joe1505/mhz100q/README.md

# mhz100q

Cloned from SourceForge. For now, see http://mhz100q.sourceforge.net/
