joe1505/mhz100q/pcb/kicad/mhz100q.sch

## KiCad design pcb/kicad/mhz100q.sch (2009-04-13)

Schematic: mhz100q.sch

Parts:
C1, C4, C8, C12, C13, C16, C17, C40, C41: C; SM0805
C2, C3, C6: 10; SM0805
C5, C7, C9, C10, C29, C30, C31, C32: 0.1; SM0805
C11, C15, C18, C20, C22, C24, C26, C27: 0.2; SM0805
C14, C19, C21, C23, C25: 1; SM0805
C28: 20; SM0805
F1, F2, F3, F4: P7LP; SIL-5
IC1: TPS6204X; TIPWRPAD10
IC2, IC3: LMH6551; MSOP8
IC4, IC5: AD8138; MSOP8
IC6, IC7, IC8, IC9: AD9283; MSOP8
J2: COPWR; co-kld-0202
J7: HIROSE100; HIROSE100TH_RE
J8, J9, J10, J11: COAXIAL_4G
L1, L2: INDUCTOR; SM0805
P9, P10: CONN_5X2; PIN_ARRAY_5x2
P11, P12, P13, P14, P15: CONN_1; 1pin
R1, R3, R4, R5, R7, R8, R10, R12: 26; SM0805
R2, R14: 14.3k; SM0805
R6, R9, R11, R13: 35; SM0805
R15, R16, R19, R20, R21, R22, R25, R26, R29, R30, R31, R32: 500; SM0805
R17: 240; SM0805
R18: 270; SM0805
R23: 15.0k; SM0805
R24: 36.0k; SM0805
R27, R28: 510; SM0805
R33: 50
R34: 56; SM0805
R35, R36: 50; SM0805

Notes on the sheet:
13apr2009 Remove breakout.
08apr2009 update channel 4 values.
