joe1505/mhz100q/pcb/mhz100q_b/a2dpath.sch

## KiCad design pcb/mhz100q_b/a2dpath.sch (2013-04-24)

Schematic: a2dpath.sch

Parts:
C14, C15, C16, C18, C22, C29: 0.1; SM0805
F3: P7LP; SIL-9
IC4: AD8138ARMZ; MSOP8
IC6: AD9283BRSZ-100; SSOP20jr
J8: COAXIAL_SG; SMA_EDGE2G
R1, R5: 26; SM0805
R6: 35; SM0805
R19: 240; SM0805
R20: 270; SM0805
R29, R30: 510; SM0805
R35: 56; SM0805

Notes on the sheet:
Impedance matching network not used.
LMH6551MM used instead of AD8138.
