joe1505/mhz100q/pcb/mhz100q_b/mhz100q_b.sch

## KiCad design pcb/mhz100q_b/mhz100q_b.sch (2013-04-24)

Schematic: mhz100q_b.sch

Parts:
C1, C41: C; SM0805
C2, C3, C6: 10; SM1206
C25: 1; SM0805
C28: 20; SM1206
C40, C42: 0.1; SM0805
D1: 1n5819; IR_D64w
J2: COPWR; co-kld-0202
J7: HIROSE100; HIROSE100TH_RE
P9, P12: CONN_3X2; pin_array_3x2
P10: CONN_4X2; pin_array_4x2
P11: CONN_1; PAD20x40
R2: Rb; SM0805
R14: Ra; SM0805
R23: 15k; SM0805
R24: 36k; SM0805
U1: YEV09T03
U2: tlv1117; SOT223

Notes on the sheet:
required values are totally different. Check the documentation.
R2 and R14 are shared by linear and switching regulators, but the
Don't install 1N5819 if either regulator is used.
3.0 volts derived from Vcc: install only 1N5819.
External power and linear regulator: install only tlv1117.
External power and switching regulator: Install only YEV09T03.
Same as Vcc (3.3 volts) - Replace 1N5819 with a wire.
Vaa - Analog supply (nominal 3 volts) has 4 options.
Vcc - A/D digital output supply - is always Nexys 3.3 volt power.
3v:491 3.3v: 436
$Id: mhz100q_b.sch,v 1.4 2011/01/19 15:34:23 jrothwei Exp $
5-12 V
For 2-channel version, only the a2dpath3 and a2dpath2 sheets are populated.
Nexys 3.3v
Vcm should be 0.3*Vaa
