joe1505/mhz100q/vhdl/src/sineram_q16b.vhd

-- $Id: sineram_q16b.vhd,v 1.2 2009/12/31 03:14:41 jrothwei Exp $
-- Copyright 2009 Joseph Rothweiler
--------------------------------------------------------------------------------
-- Joseph Rothweiler, Sensicomm LLC. Started 30Dec2009.
-- Using Xilinx Spartan 3E  internal block RAM as a 1k words x 16 bits RAM.
-- RAM contents is a quarter-sine wave, scaled 0 to 65535.
----------------------------------------------------------------------------------
library IEEE;
use IEEE.STD_LOGIC_1164.ALL;
use IEEE.STD_LOGIC_ARITH.ALL;
use IEEE.STD_LOGIC_UNSIGNED.ALL;

library UNISIM;
use UNISIM.VComponents.all;

entity sineram_q16b is
    Port (
      clock1   : in  STD_LOGIC;
      addr1    : in  STD_LOGIC_VECTOR ( 9 downto 0);
      data1out : out STD_LOGIC_VECTOR (15 downto 0);
      --
      clock2   : in  STD_LOGIC;
      addr2    : in  STD_LOGIC_VECTOR ( 9 downto 0);
      data2out : out STD_LOGIC_VECTOR (15 downto 0)
    );
end sineram_q16b ;

architecture Behavioral of sineram_q16b is
  signal CLKA  : std_logic;                     -- Port A Clock
  signal CLKB  : std_logic;                     -- Port B Clock
  signal DOA  : STD_LOGIC_VECTOR(15 downto 0); -- A Data Output - lsb's used.
  signal DOB  : STD_LOGIC_VECTOR(15 downto 0); -- B Data Output - lsb's used.
  signal DIA  : STD_LOGIC_VECTOR(15 downto 0); -- A Data Input - lsb's used.
  signal DIB  : STD_LOGIC_VECTOR(15 downto 0); -- B Data Input - lsb's used.
  signal DOPA : STD_LOGIC_VECTOR( 1 downto 0); -- A Parity Out. Unused.
  signal DOPB : STD_LOGIC_VECTOR( 1 downto 0); -- B Parity Out. Unused.
  signal DIPA : STD_LOGIC_VECTOR( 1 downto 0); -- A Parity In. Unused.
  signal DIPB : STD_LOGIC_VECTOR( 1 downto 0); -- B Parity In. Unused.
  signal ENA  : STD_LOGIC := '1';              -- A Enable. Not changed.
  signal ENB  : STD_LOGIC := '1';              -- B Enable. Not changed.
  signal SSRA : STD_LOGIC := '0';              -- A Sync Set/Reset. Not changed.
  signal SSRB : STD_LOGIC := '0';              -- B Sync Set/Reset. Not changed.
  -- signal data1in : STD_LOGIC_VECTOR (15 downto 0); -- Dummy. Not used.
  -- signal data2in : STD_LOGIC_VECTOR (15 downto 0); -- Dummy. Not used.
  signal write1  : STD_LOGIC := '0'; -- Dummy. Not used.
  signal write2  : STD_LOGIC := '0'; -- Dummy. Not used.
begin

   -- RAMB16_S18_S18: Virtex-II/II-Pro, Spartan-3/3E 2k x 8 + 1 Parity bit Dual-Port RAM
   -- Xilinx HDL Language Template.


   RAMB16_S18_S18_inst : RAMB16_S18_S18
   generic map (
      INIT_A => X"000", --  Value of output RAM registers on Port A at startup
      INIT_B => X"000", --  Value of output RAM registers on Port B at startup
      SRVAL_A => X"000", --  Port A ouput value upon SSR assertion
      SRVAL_B => X"000", --  Port B ouput value upon SSR assertion
      WRITE_MODE_A => "WRITE_FIRST", --  WRITE_FIRST, READ_FIRST or NO_CHANGE
      WRITE_MODE_B => "WRITE_FIRST", --  WRITE_FIRST, READ_FIRST or NO_CHANGE
      SIM_COLLISION_CHECK => "ALL", -- "NONE", "WARNING", "GENERATE_X_ONLY", "ALL" 
      -- The following INIT_xx declarations specify the initial contents of the RAM
      --
--             0f  0e  0d  0c  0b  0a  09  08  07  06  05  04  03  02  01  00
INIT_00 => X"061605b2054d04e90484042003bb035602f2028d022901c4016000fb00970032",
INIT_01 => X"0c5d0bf90b950b300acc0a670a03099e093a08d50871080d07a8074406df067b",
INIT_02 => X"12a3123f11da1176111210ad10490fe50f800f1c0eb80e530def0d8b0d260cc2",
INIT_03 => X"18e61881181d17b9175516f1168d162915c5156014fc1498143413d0136b1307",
INIT_04 => X"1f241ec11e5d1df91d951d311ccd1c691c051ba21b3e1ada1a761a1219ae194a",
INIT_05 => X"255e24fb2497243423d0236d230922a6224221de217b211720b320501fec1f88",
INIT_06 => X"2b922b2f2acc2a692a0629a3294028dc2879281627b3274f26ec2689262525c2",
INIT_07 => X"31c0315d30fb309830352fd32f702f0d2eaa2e472de42d812d1e2cbc2c592bf6",
INIT_08 => X"37e63784372136bf365d35fb3599353634d43471340f33ad334a32e832853223",
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
INIT_3e => X"ffeaffe7ffe5ffe2ffdfffdbffd8ffd4ffd1ffcdffc9ffc5ffc0ffbcffb7ffb3",
INIT_3f => X"fffffffffffffffefffdfffdfffcfffbfff9fff8fff6fff5fff3fff1ffefffec",
      -- -----------------------------------------------------------------------------
      -- The next set of INITP_xx are for the parity bits
      -- Address 0 to 511
      INITP_00 => X"0000000000000000000000000000000000000000000000000000000000000000",
      INITP_01 => X"0000000000000000000000000000000000000000000000000000000000000000",
      -- Address 512 to 1023
      INITP_02 => X"0000000000000000000000000000000000000000000000000000000000000000",
      INITP_03 => X"0000000000000000000000000000000000000000000000000000000000000000",
      -- Address 1024 to 1535
      INITP_04 => X"0000000000000000000000000000000000000000000000000000000000000000",
      INITP_05 => X"0000000000000000000000000000000000000000000000000000000000000000",
      -- Address 1536 to 2047
      INITP_06 => X"0000000000000000000000000000000000000000000000000000000000000000",
      INITP_07 => X"0000000000000000000000000000000000000000000000000000000000000000"
   )
   port map (
      DOA => DOA,      -- Port A 16-bit Data Output
      DOB => DOB,      -- Port B 16-bit Data Output
      DOPA => DOPA,    -- Port A 2-bit Parity Output
      DOPB => DOPB,    -- Port B 2-bit Parity Output
      ADDRA => addr1,  -- Port A 10-bit Address Input
      ADDRB => addr2,  -- Port B 10-bit Address Input
      CLKA => CLKA,    -- Port A Clock
      CLKB => CLKB,    -- Port B Clock
      DIA => DIA,      -- Port A 16-bit Data Input
      DIB => DIB,      -- Port B 16-bit Data Input
      DIPA => DIPA,    -- Port A 2-bit parity Input
      DIPB => DIPB,    -- Port-B 2-bit parity Input
      ENA => ENA,      -- Port A RAM Enable Input
      ENB => ENB,      -- PortB RAM Enable Input
      SSRA => SSRA,    -- Port A Synchronous Set/Reset Input
      SSRB => SSRB,    -- Port B Synchronous Set/Reset Input
      WEA => write1,   -- Port A Write Enable Input
      WEB => write2    -- Port B Write Enable Input
   );
   data1out <= DOA;
   CLKA <= clock1;

   data2out <= DOB;
   CLKB <= clock2;
end Behavioral;
