joe1505/mhz100q/(commit log)

2009-04-13 Set up directories, post PCB design.
    [mhz100q.brd, mhz100q.sch]
2009-07-02 Bug fixes, add status return on EP8, add kbhit_nowait.c
    [scope_top.vhd]
2010-12-29 Add sine test output signal, other minor fixes.
    [bytecmd.vhd, scope_top.vhd]
2011-10-26 Add top-level vhdl for pcb rev 2: mhz100q2
2013-04-22 add kicad symbol lib and net file
2013-04-24 Add mhz100q_b - updated 4-channel pcb
    [a2dpath.sch, mhz100q_b.brd, mhz100q_b.sch]
